geoalx/Liv85/SYSTEM/Schematic_8085.pdf

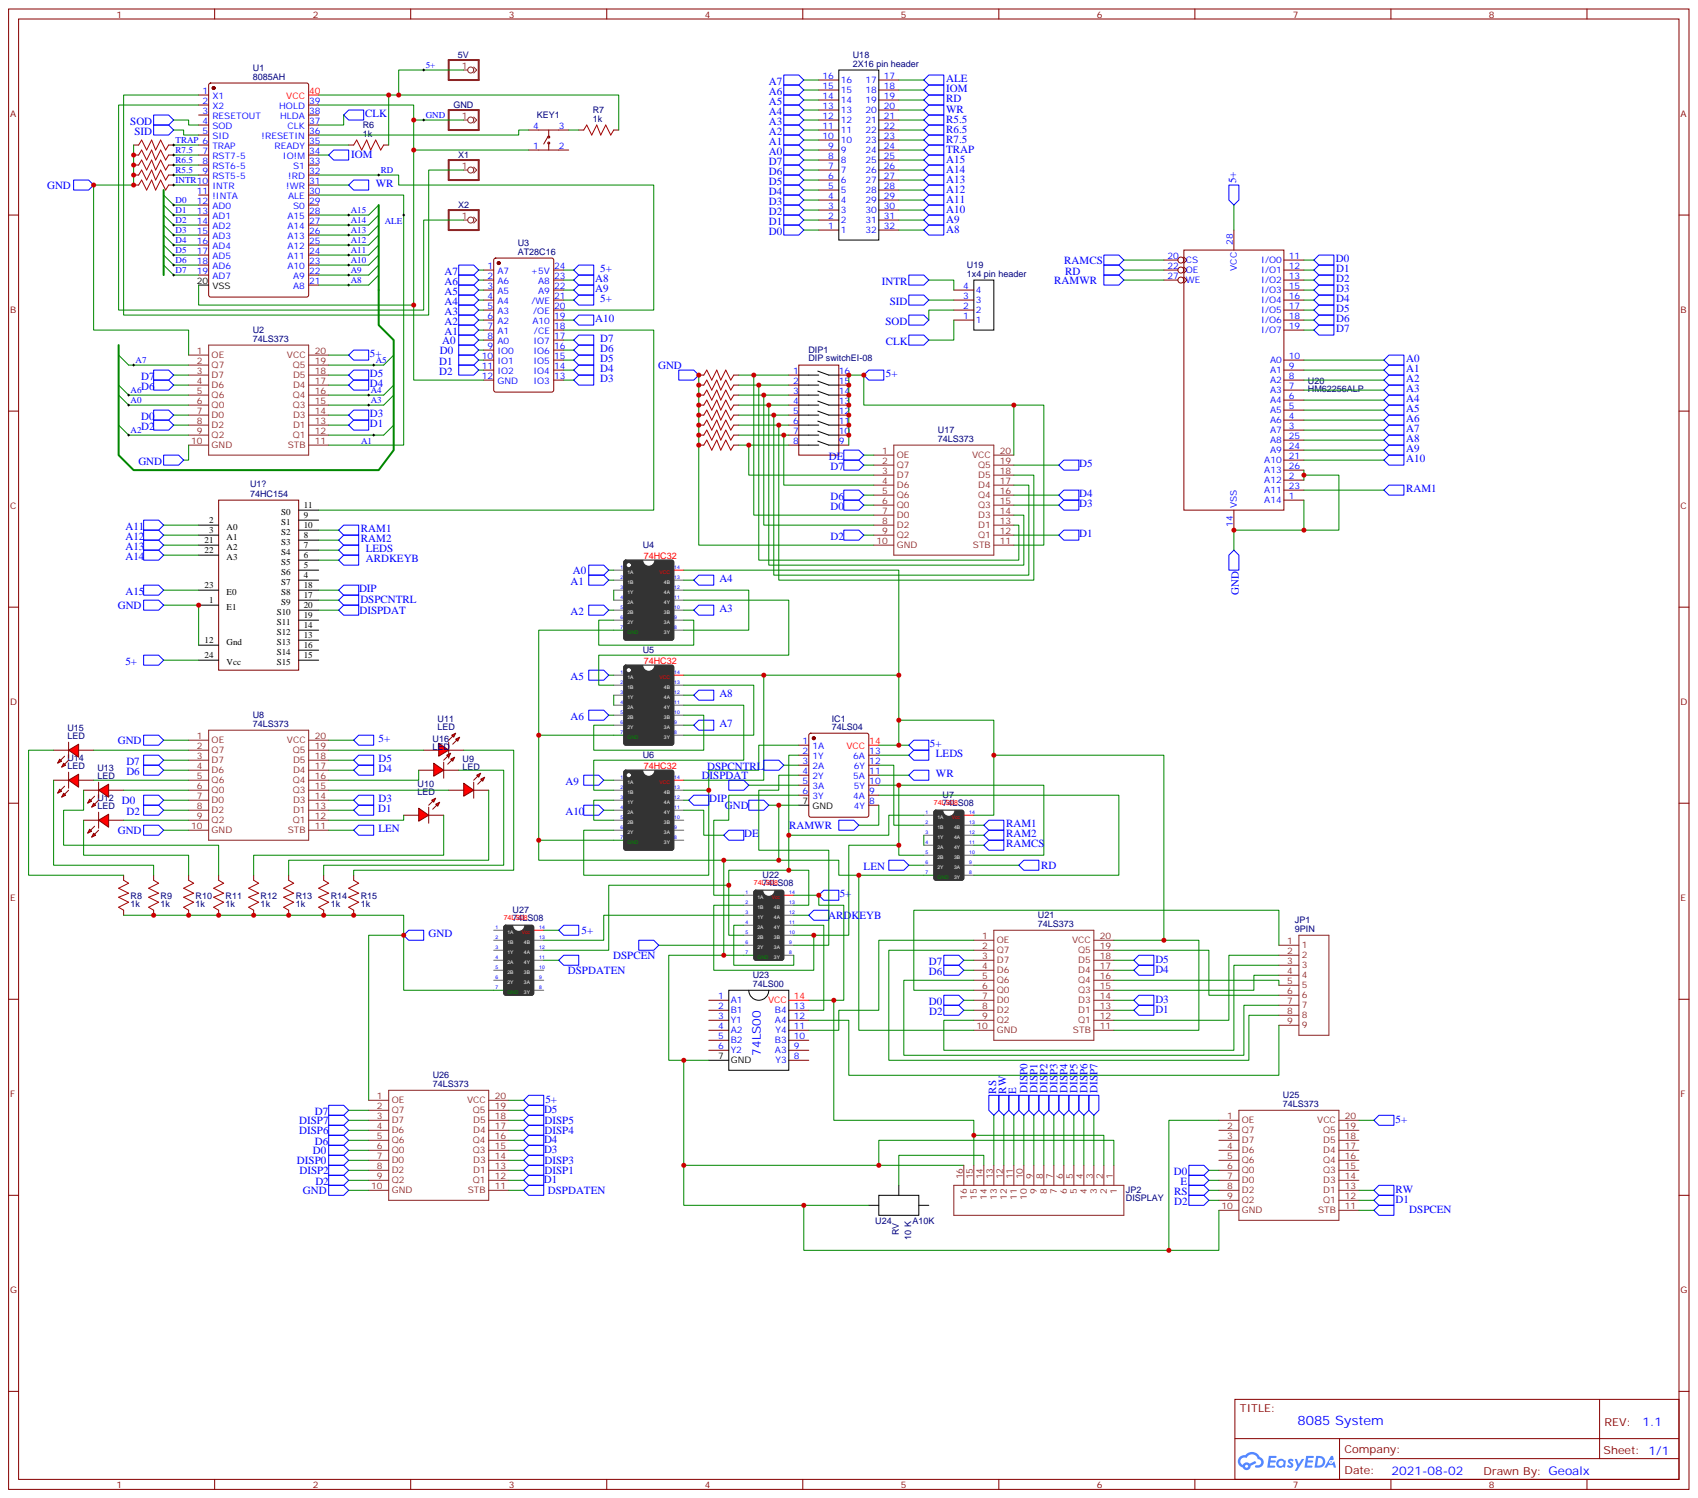
[picture p4: page 1]
