geoalx/Liv85/WRITER/Schematic_eeprom_programmer_pico_full.pdf

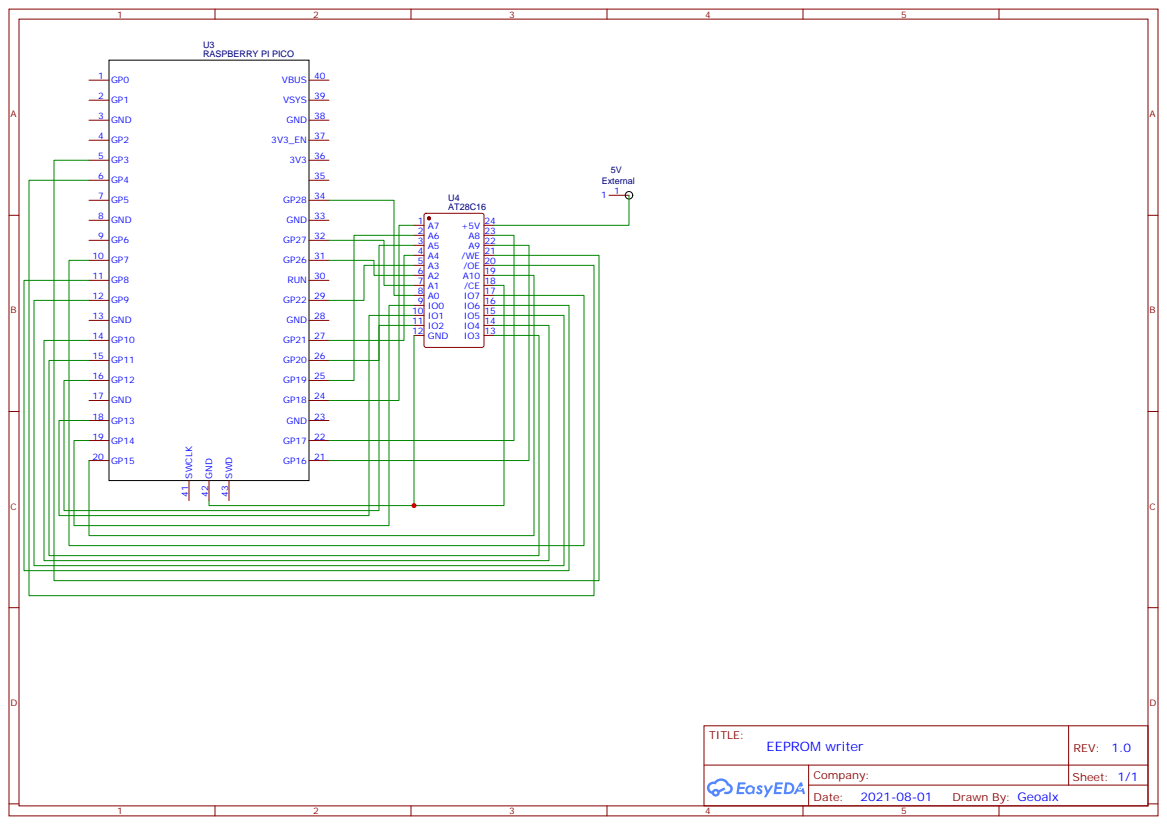
[picture p5: page 1]
