geoalx/Liv85/(commit log)

2021-08-01 1.0 release
    release of the first version of the assembler-writer system
2021-08-01 schematic image
2021-08-05 bug fix in comment support
    [start.py]
2021-08-06 bug fix in LXI SP
    [start.py]
2022-10-12 added more schematics
